etherkit/Si5351ABreakoutBoard/documentation/Si5351ABreakout.png

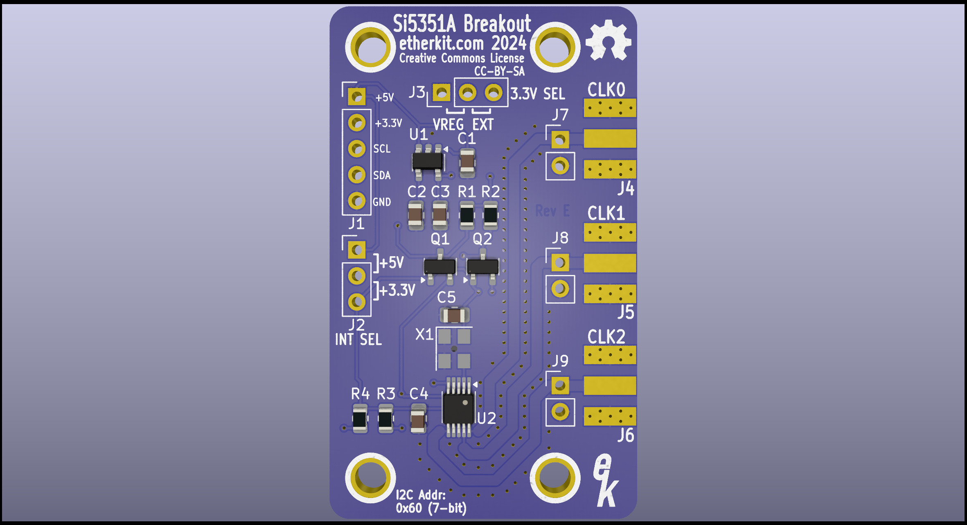
documentation/Si5351ABreakout.png
