etherkit/Si5351ABreakoutBoard/pcb/production/Si5351ABreakout_RevF_BOM_JLCPCB.csv

Comment | Designator | Footprint | LCSC Part #
1u MLCC | C1 | Capacitor_SMD:C_0805_2012Metric | C28323
100n | C2,C4-C6 | Capacitor_SMD:C_0805_2012Metric | C49678
4.7u MLCC | C3 | Capacitor_SMD:C_0805_2012Metric | C1779
BSS138 | Q1,Q2 | Package_TO_SOT_SMD:SOT-23 | C40912
10k | R1-R4 | Resistor_SMD:R_0805_2012Metric | C17414
10R | R5 | Resistor_SMD:R_0805_2012Metric | C17415
LP2985-3.3 | U1 | Package_TO_SOT_SMD:SOT-23-5 | C16085
Si5351A-B | U2 | Package_SO:MSOP-10_3x3mm_P0.5mm | C504891
25MHz TCXO | X1 | Oscillator:Oscillator_SMD_SeikoEpson_SG8002CE-4Pin_3.2x2.5mm | C48888230
