etherkit/Si5351ABreakoutBoard/documentation/Si5351ABreakoutRevF.pdf

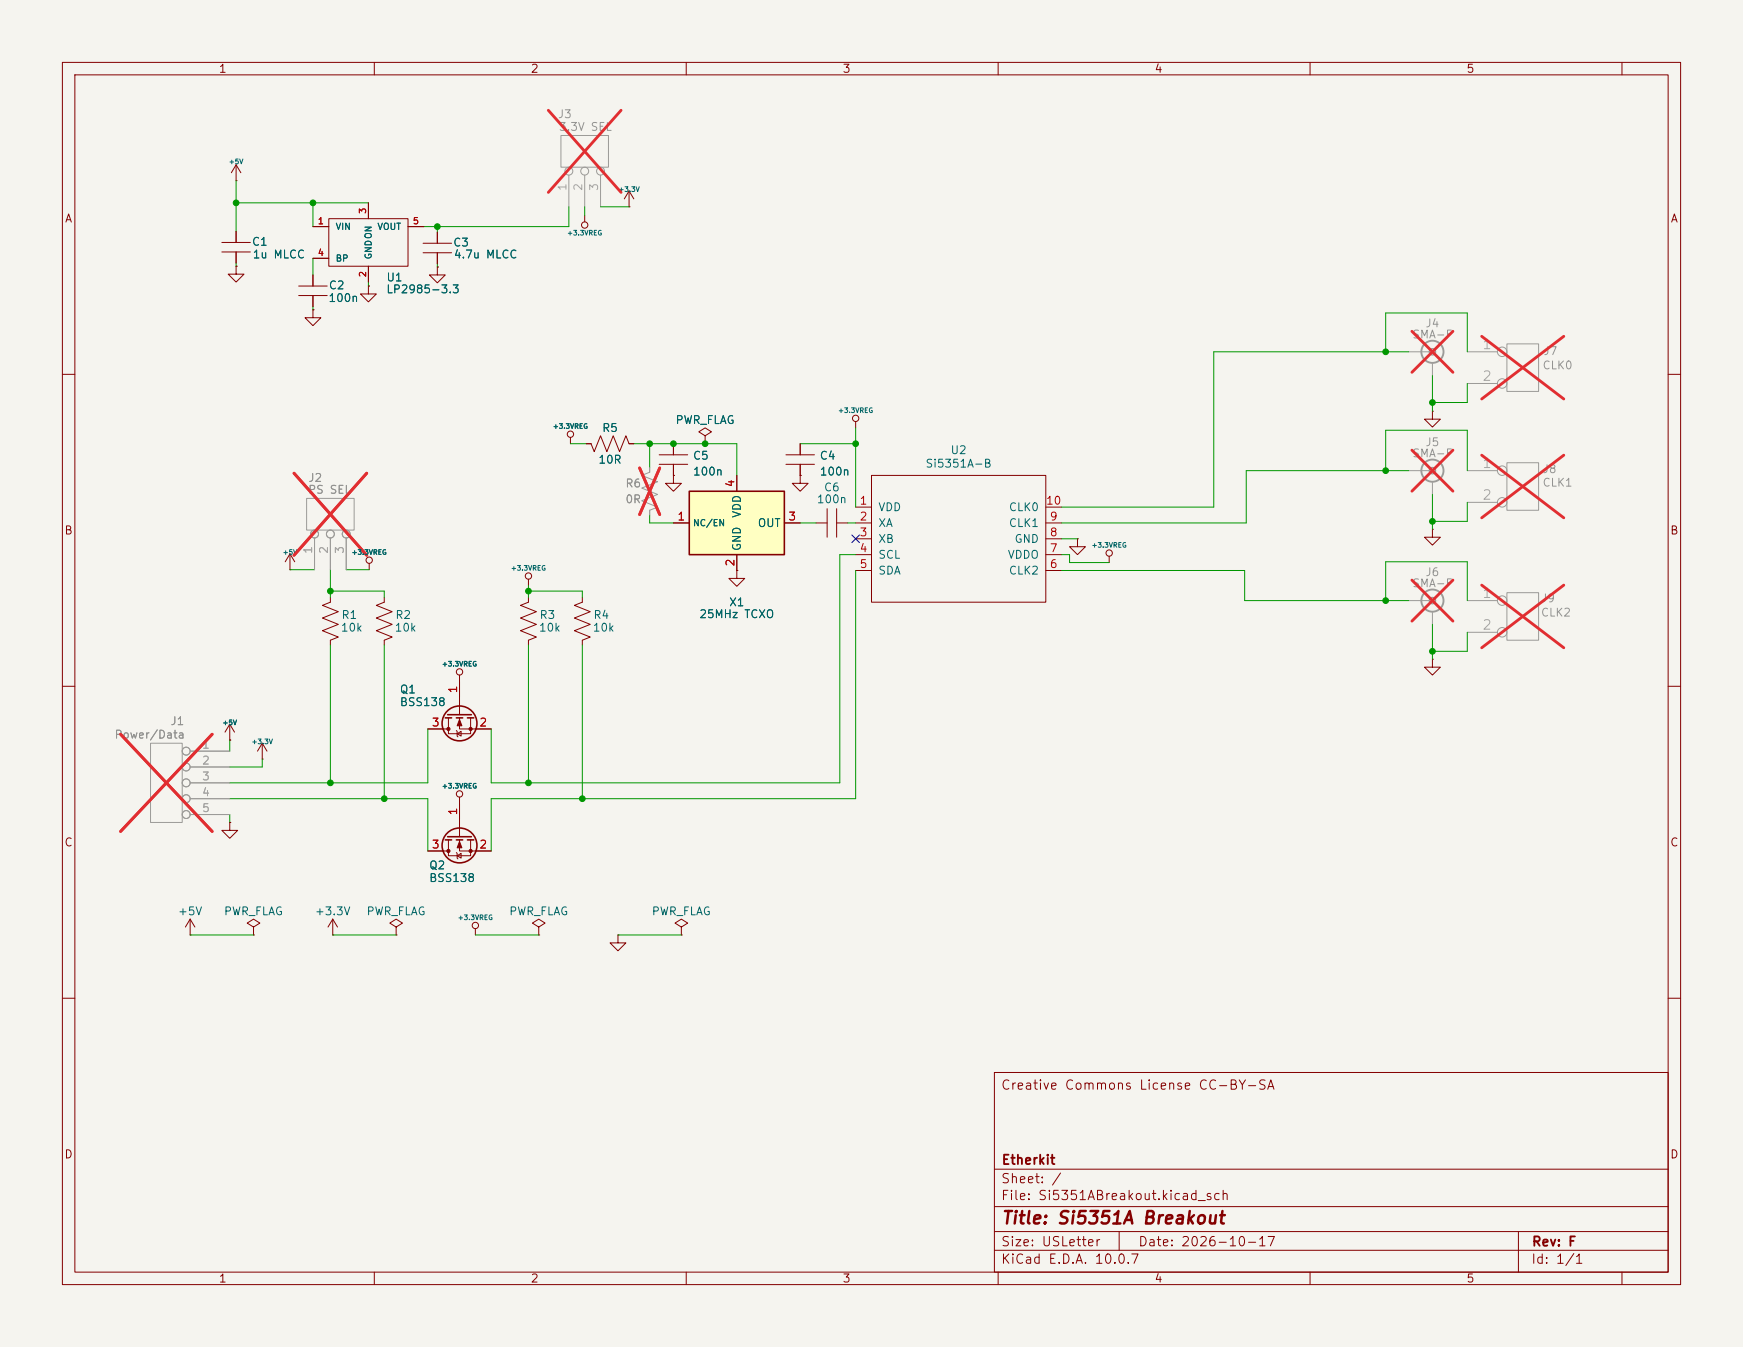
[picture p2: page 1]

Creative Commons License CC-BY-SA

Size: USLetter | Rev: F
KiCad E.D.A. 10.0.7 | Id: 1/1
