etherkit/Si5351ABreakoutBoard/documentation/Si5351ABreakoutRevD.pdf

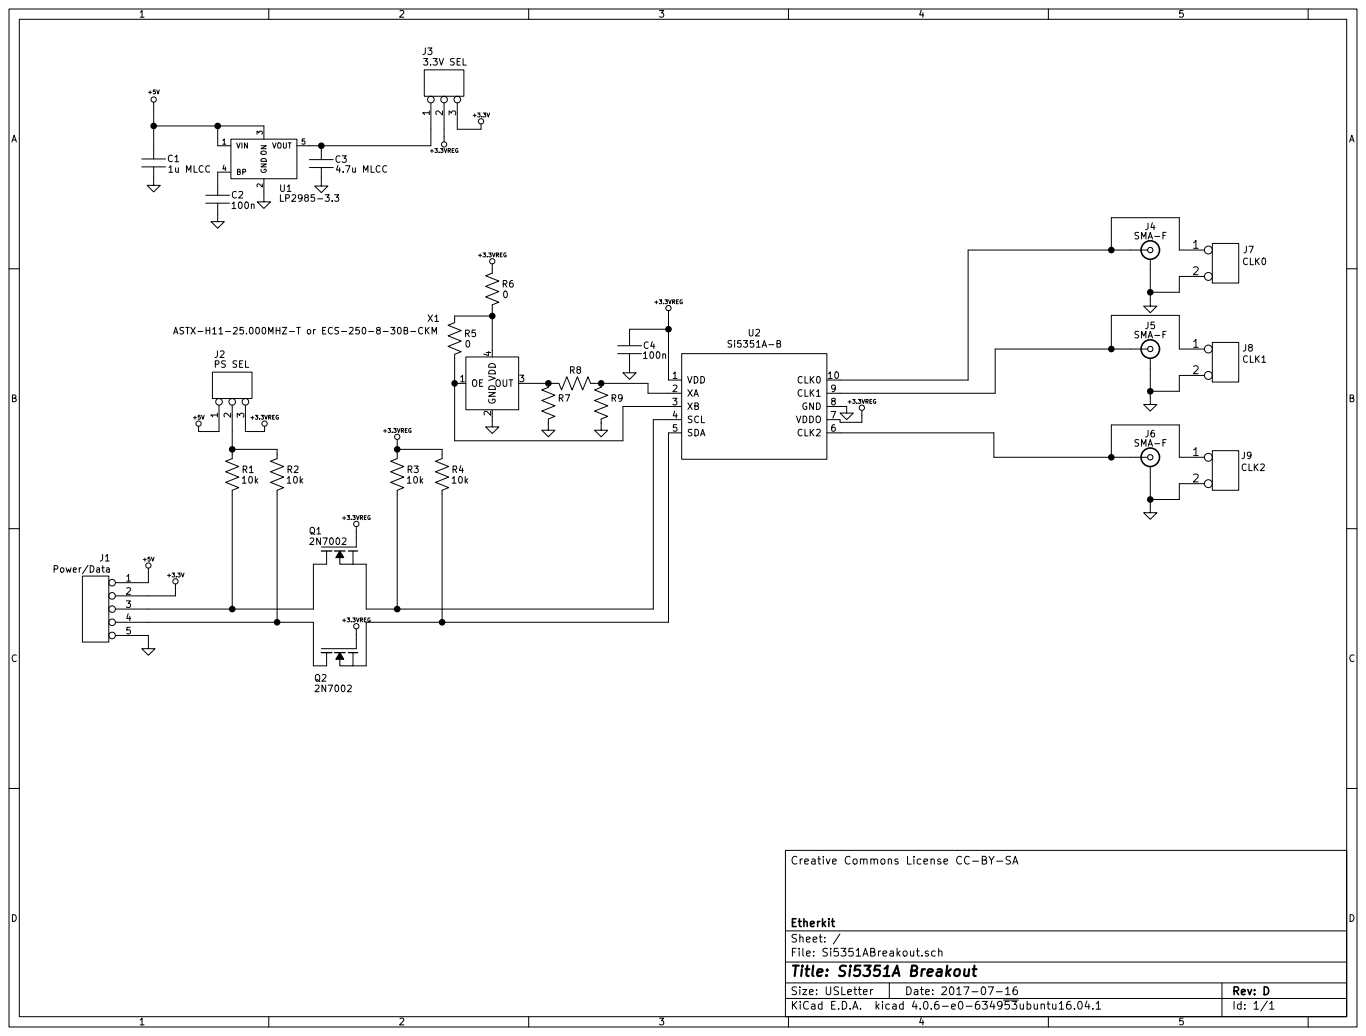
[picture p3: page 1]

4 X1 ASTX-H11-25.000MHZ-T or ECS-250-8-30B-CKM

Id: 1/1 Title: Si5351A Breakout File: Si5351ABreakout.sch Sheet: / Etherkit Creative Commons License CC-BY-SA
