etherkit/Si5351ABreakoutBoard/pcb/Si5351ABreakout.kicad_sch

## KiCad design pcb/Si5351ABreakout.kicad_sch (2026-11-11)

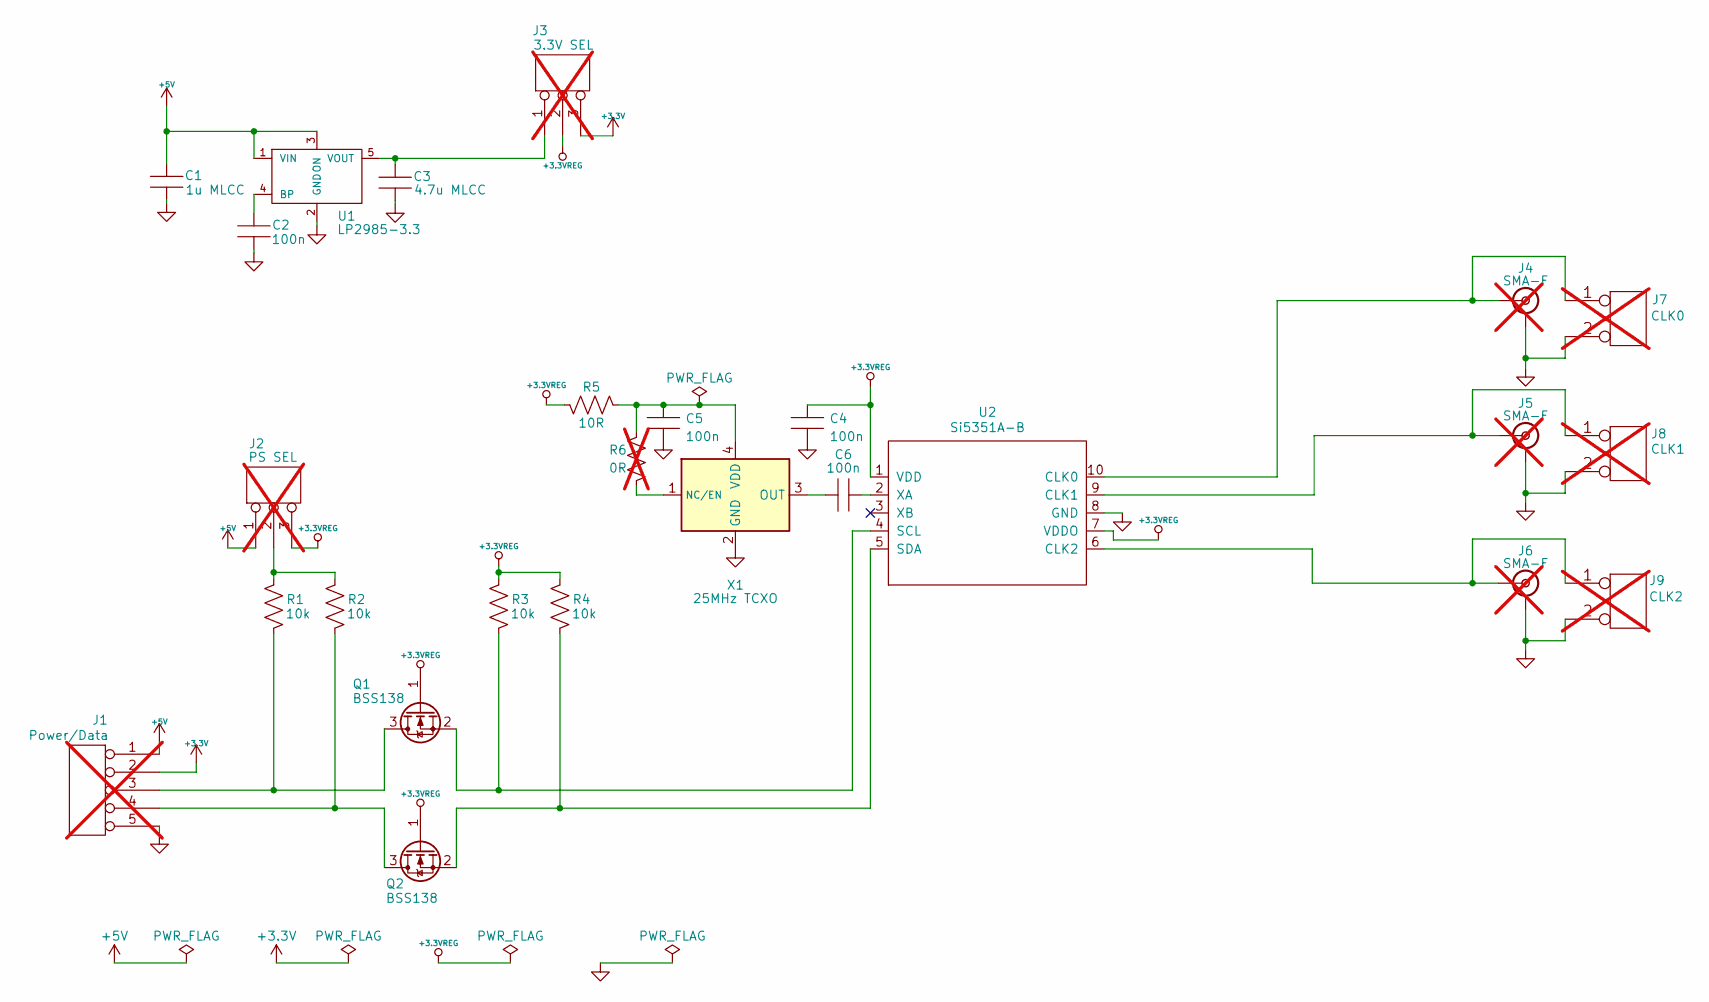
[picture p4: schematic Si5351ABreakout.kicad_sch]

Parts:
C1: 1u MLCC; C_0805_2012Metric; MPN CL21B105KBFNNNE; LCSC C28323
C2, C4, C5, C6: 100n; C_0805_2012Metric; MPN CC0805KRX7R9BB104; LCSC C49678
C3: 4.7u MLCC; C_0805_2012Metric; MPN CL21A475KAQNNNE; LCSC C1779
J1: Power/Data; Pin_Header_Straight_1x05_Pitch2.54mm; not fitted
J2: PS SEL; Pin_Header_Straight_1x03_Pitch2.54mm; not fitted
J3: 3.3V SEL; Pin_Header_Straight_1x03_Pitch2.54mm; not fitted
J4, J5, J6: SMA-F; SMA-ENDLAUNCH; not fitted
J7: CLK0; Pin_Header_Straight_1x02_Pitch2.54mm; not fitted
J8: CLK1; Pin_Header_Straight_1x02_Pitch2.54mm; not fitted
J9: CLK2; Pin_Header_Straight_1x02_Pitch2.54mm; not fitted
Q1, Q2: BSS138; SOT-23; MPN BSS138-7-F; LCSC C40912
R1, R2, R3, R4: 10k; R_0805_2012Metric; MPN 0805W8F1002T5E; LCSC C17414
R5: 10R; R_0805_2012Metric; MPN 0805W8F100JT5E; LCSC C17415
R6: 0R; R_0805_2012Metric; MPN 0805W8F0000T5E; LCSC C17477; not fitted
U1: LP2985-3.3; SOT-23-5; MPN LP2985AIM5-3.3/NOPB; LCSC C16085
U2: Si5351A-B; MSOP-10_3x3mm_P0.5mm; MPN SI5351A-B-GTR; LCSC C504891
X1: 25MHz TCXO; Oscillator_SMD_SeikoEpson_SG8002CE-4Pin_3.2x2.5mm; MPN OW2EL89CENUXK7YLC-25M; LCSC C48888230

Connections:
+3.3V: J1.2, J3.3
+3.3VREG: C4.1, J2.3, J3.2 (PM), Q1.1 (G), Q2.1 (G), R3.1, R4.1, R5.1, U2.1 (VDD), U2.7 (VDDO)
+5V: C1.1, J1.1, J2.1, U1.1 (VIN), U1.3 (ON)
GND: C1.2, C2.2, C3.2, C4.2, C5.2, J1.5, J4.2 (Ext), J5.2 (Ext), J6.2 (Ext), J7.2 (PM), J8.2 (PM), J9.2 (PM), U1.2 (GND), U2.8 (GND), X1.2 (GND)
unnamed: C2.1, U1.4 (BP)
unnamed: C3.1, J3.1, U1.5 (VOUT)
unnamed: C5.1, R5.2, R6.1, X1.4 (VDD)
unnamed: C6.1, X1.3 (OUT)
unnamed: C6.2, U2.2 (XA)
unnamed: J1.3, Q1.3 (D), R1.2
unnamed: J1.4, Q2.3 (D), R2.2
unnamed: J2.2 (PM), R1.1, R2.1
unnamed: J4.1 (In), J7.1, U2.10 (CLK0)
unnamed: J5.1 (In), J8.1, U2.9 (CLK1)
unnamed: J6.1 (In), J9.1, U2.6 (CLK2)
unnamed: Q1.2 (S), R3.2, U2.4 (SCL)
unnamed: Q2.2 (S), R4.2, U2.5 (SDA)
unnamed: R6.2, X1.1 (NC/EN)
