etherkit/Si5351ABreakoutBoard/(commit log)

2014-07-07 Schematic fix
    [Si5351ABreakout.sch]
2014-08-07 Rev B - I2C level conv, voltage regulator
    [Si5351ABreakout.kicad_pcb, Si5351ABreakout.sch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]
2015-01-18 Rev C updates
    [Si5351ABreakout.kicad_pcb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]
2015-02-16 Update schematic, PCB 50 ohm output traces
    [Si5351ABreakout-B_Cu.gbr, Si5351ABreakout-B_Mask.gbr, Si5351ABreakout-B_SilkS.gbr, Si5351ABreakout-Edge_Cuts.gbr, Si5351ABreakout-F_Cu.gbr, Si5351ABreakout-F_Mask.gbr, Si5351ABreakout-F_Paste.gbr, Si5351ABreakout-F_SilkS.gbr]
2015-10-04 Add mechanical drawing
    [Si5351ABreakout.kicad_pcb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]
2016-04-11 Update BOM for new TCXO
    [Si5351ABreakout.sch]
2017-01-29 Rev D PCB changes
    [Si5351ABreakout.kicad_pcb, Si5351ABreakout.sch]
2017-07-16 Rev D Update
    [Si5351ABreakout-B.Cu.gbr, Si5351ABreakout-B.Mask.gbr, Si5351ABreakout-B.SilkS.gbr, Si5351ABreakout-Dwgs.User.gbr, Si5351ABreakout-Edge.Cuts.gbr, Si5351ABreakout-F.Cu.gbr, Si5351ABreakout-F.Mask.gbr, Si5351ABreakout-F.Paste 80pct.gbr]
2021-03-24 Update BOM to indicate new TCXO
2026-10-17 Rev E KiCad 8 port (as found on local working copy)
    Imported verbatim from the oberon working tree (hashes verified). Excludes KiCad backups, rescue-backup, fp-info-cache, lock file, kicad_sch-bak and production/ outputs; adds .gitignore for them.
2026-10-17 Save in KiCad 10 format
    kicad-cli sch/pcb upgrade (KiCad 10.0.7): sch 20231120->20260306, pcb 20240108->20260206.
    3D model paths: ${KICAD8_3DMODEL_DIR}/*.wrl -> ${KICAD10_3DMODEL_DIR}/*.step for C/R 0805, SOT-23-3, SOT-23-5, MSOP-10.
    X1: SG8002CE .wrl has no KiCad 10 STEP; use Crystal_SMD_3225-4Pin_3.2x2.5mm.step as stand-in.
    Pin headers: legacy Pin_Headers.3dshapes/*.wrl -> Connector_PinHeader_2.54mm PinHeader_1xNN_P2.54mm_Vertical.step, offset/rotate reset to 0 (verified aligned in 3D render).
    ERC/DRC counts unchanged vs Rev E baseline (ERC 4 errors power_pin_not_driven; DRC 0 errors).
2026-10-17 Rev F: AC-coupled YXC TCXO into XA
    - X1: YXC OW2EL89CENUXK7YLC-25M (LCSC C48888230), new project-local
    symbol Si5351ABreakout:TCXO_4P (1 NC, 2 GND, 3 OUT, 4 VDD). Pin 1 is
    no longer tied to GND; no-connect flag added.
    - C6 100n X7R 0805 (CC0805KRX7R9BB104, C49678) in series X1 OUT -> XA
    (Si5351 DS 6.6 Fig.14 / AN1423 Q7). XB left floating.
    - R5 10R 0805 (0805W8F100JT5E, C17415) from +3.3VREG to X1 VDD; C5 now
    100n (C49678) on the X1 side of R5.
    - PWR_FLAGs on +5V, +3.3V, +3.3VREG, GND and the filtered X1 VDD node.
    - J1-J9 marked DNP (matches board).
    - LCSC numbers moved out of MPN into LCSC/MPN/Manufacturer fields.
    - U2 snapped to the 1.27 mm grid (+0.127 mm X); oscillator/U2 supply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
2026-10-17 Rev F: layout for TCXO changes
    - Board synced to the Rev F schematic: new C6 (100n, C_0805) and R5
    (10R, R_0805) with schematic paths; new nets Net-(X1-OUT),
    Net-(X1-VDD); X1 pad 1 now unconnected-(X1-NC-Pad1) (GND removed);
    MPN/Manufacturer/LCSC fields on all fitted footprints; values X1
    "25MHz TCXO", C5 "100n".
    - X1 moved 3.4 mm up (112.15,83.4 -> 112.15,80.0) so C6 sits vertically
    between X1.3 and U2.2 (XA): XA copper is now C6.2->U2.2 ~2 mm.
    - C5 (X1 VDD decoupler) right of X1.4, GND to the stitching via fence;
    R5 below C5, fed from the U2 VDD pad.
    - GND vias added at X1.2 (109.9,81.2), (110.1,82.4) and (109.0,78.3);
    one fence via (115.9,84.8) removed (it fell inside R5 pad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
2026-10-17 Rev F: BSS138 level shifters, silkscreen fixes, part field refresh
    - Q1/Q2: 2N7002 -> BSS138-7-F (Diodes Inc, LCSC C40912), SOT-23 footprint; nets unchanged
    - Reroute Q1 gate tie (+3.3VREG) via B.Cu to clear larger SOT-23 pads
    - Silkscreen year 2024 -> 2026; C5/C6/R5 refs rotated to 0 deg
    - Add DNP R6 (0R 0805, 0805W8F0000T5E / C17477) from X1 VDD to X1 pin 1 for future active-high-enable TCXO; TCXO_4P pin 1 renamed NC/EN (passive)
    - Board fields synced with schematic
2026-10-17 Remove obsolete Rev C/D production outputs
    Old panel Gerbers, drill files, gerbv project and zip, plus the Rev D single-board drill file. Rev F outputs are added under pcb/production/.
2026-10-17 Add Rev F JLCPCB production files
    pcb/production/: Gerbers + Excellon drill (gerbers/, also zipped as Si5351ABreakout_RevF_gerbers.zip for upload), JLCPCB BOM and CPL CSVs, drill maps and job file, and the combined Si5351ABreakout_RevF_JLCPCB.zip. Generated with kicad-cli 10.0.7 from 6634bb6. .gitignore: track pcb/production/, ignore pcb/production/old/.
2026-10-17 Add Rev F schematic PDF
    documentation/Si5351ABreakoutRevF.pdf, exported with kicad-cli 10.0.7 (color, all sheets) from the Rev F schematic (6634bb6). Older revision PDFs kept.
