etherkit/Si5351ABreakoutBoard/(notices)

Notices in the files:
pcb/Si5351ABreakout_single.kicad_pcb:
Creative Commons Licence CC-BY-SA
